Dennis-van-Gils/Infinity_mirror_FastLED/Solidworks/ikea-ribba-frame-23x23cm-1.snapshot.1/RIBBA.JPG

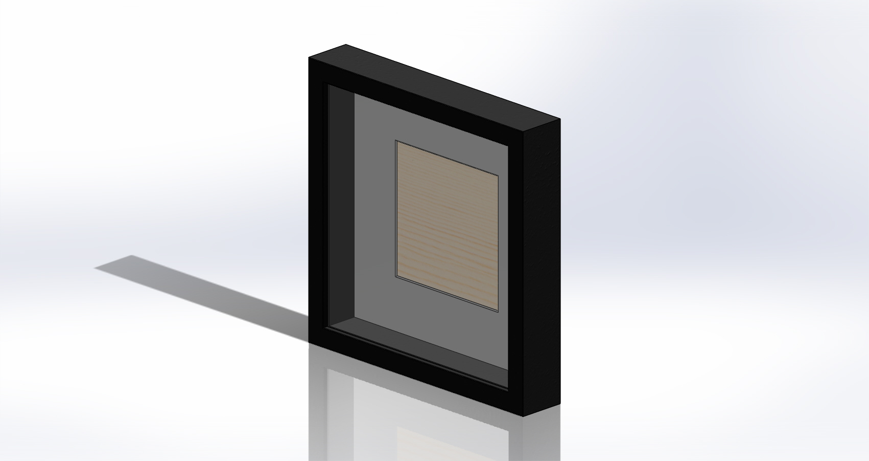
Solidworks/ikea-ribba-frame-23x23cm-1.snapshot.1/RIBBA.JPG
