Dennis-van-Gils/Infinity_mirror_FastLED/Solidworks/mcu_enclosure.PNG

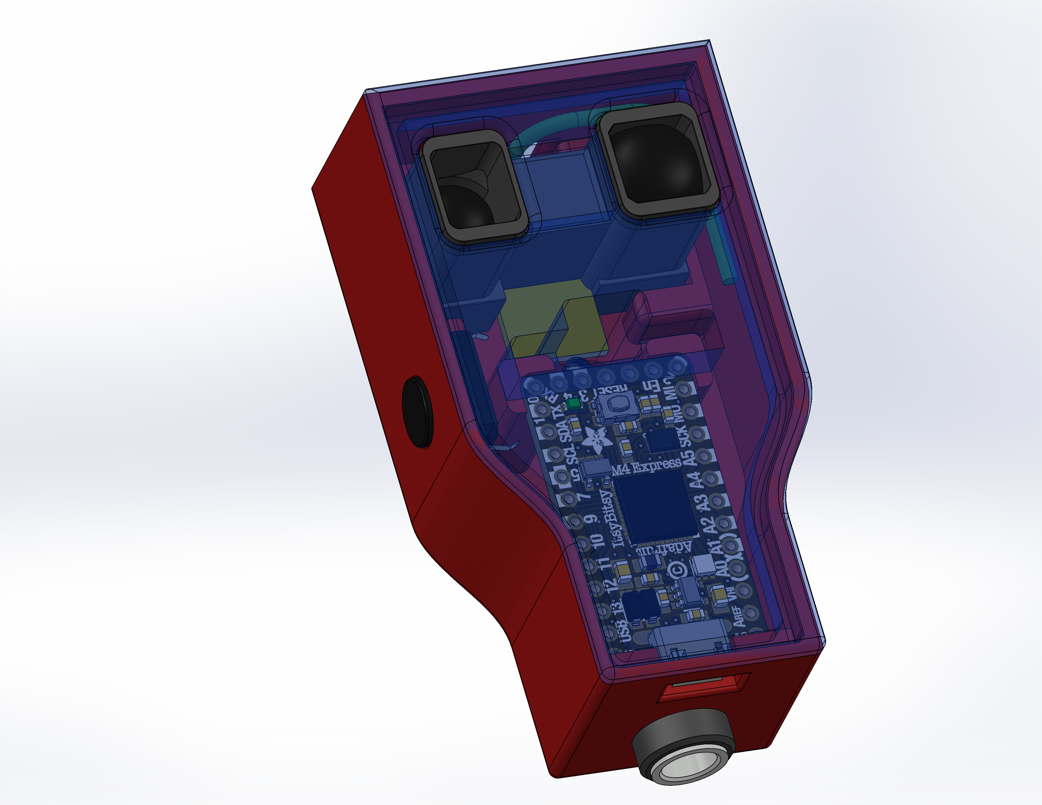
Solidworks/mcu_enclosure.PNG
