Dennis-van-Gils/Infinity_mirror_FastLED/notes.txt

* Adafruit Feather/ItsyBitsy M4 Express

* RGB LED strip
  LS5RGB60 APA102 CP from LEDTUNING.NL
  'Dotstar' type
  5 V, 5050

  Testing 52 leds:
    5 V, 2.5 A switching power supply:
      max current @ full white = 1.3 A

    5 V, 2.0 A switching power supply:
      max current @ full white = 1.13 A
      --> underpowered PSU

  --> strip direction -->

                pin
  VCC - Brown
  CLK - White   SPI_SCK
  DAT - Blue    SPI_MOSI
  GND - Black  

  Adafruit recommends:
  Add a 1000µF (6.3V or higher) capacitor close to the strip between VCC and GND

* IR distance sensor
  Sharp 2Y0A02
  
  Brown: 3.3V
  Black: GND
  Blue : analog out to pin A0 on Arduino           
  
  Fit: distance [cm] = A / bitval ^ C - B, where bitval is at 10-bit
  
* Standby currents
  
  IR distance sensor, running    : ~ 30 mA
  RGB LED strip with all leds off: ~ 58 mA
                                   -------
                                     88 mA
                                     
* SAMD51 Standby mode snippet
  Is hardly worth it, because of the large standby currents of the IR distance
  sensor and RGB LED strip.
  
  #include "Adafruit_SleepyDog.h"
  
  USB->DEVICE.CTRLA.bit.ENABLE = 0;          // Disable the USB peripheral
  while (USB->DEVICE.SYNCBUSY.bit.ENABLE) {} // Wait for synchronization
  USB->DEVICE.CTRLA.bit.RUNSTDBY = 0;        // Deactivate run on standby
  USB->DEVICE.CTRLA.bit.ENABLE = 1;          // Enable USB peripheral
  while (USB->DEVICE.SYNCBUSY.bit.ENABLE) {} // Wait for synchronization

  Watchdog.sleep(1000);
