Dennis-van-Gils/Infinity_mirror_FastLED/docs/UML_FSM.pdf

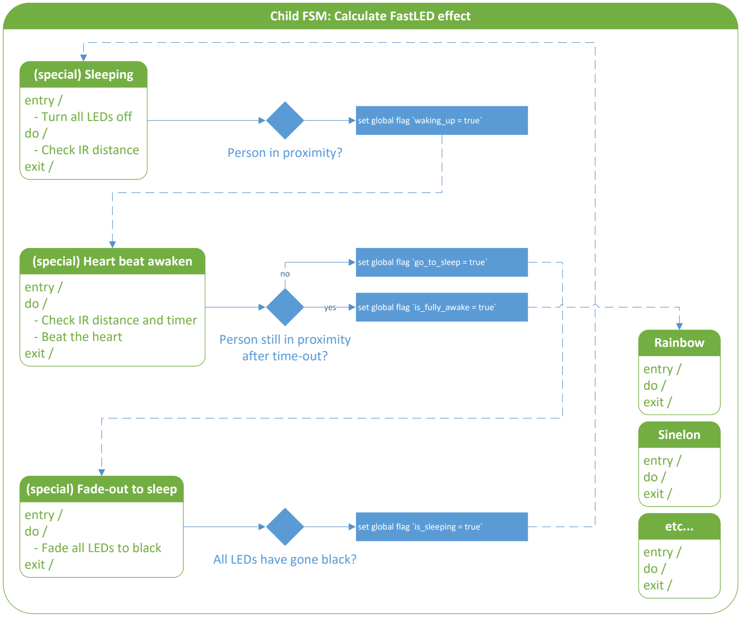
[picture p18: figure]
Child FSM: Calculate FastLED effect; Rainbow; entry / do / exit /; Sinelon; etc...; (special) Heart beat awaken; entry / do / - Check IR distance and timer - Beat the heart exit /; (special) Fade-out to sleep; entry / do / - Fade all LEDs to black exit /; (special) Sleeping; entry / - Turn all LEDs off do / - Check IR distance exit /; Person in proximity?; set global flag `waking_up = true`; All LEDs have gone black?; Person still in proximity after time-out?; set global flag `go_to_sleep = true`; set global flag `is_sleeping = true`

Notes: Modes menu

Menu will indicate mode by lighting up 1 of the 4 corners of the mirror: └ mode 1: show effect from preset list, auto-advance
┘ mode 2: show effect from preset list, no auto-advance
┐ mode 3: show IR distance demo (hue = IR distance)
┌ mode 4: ...

Notes: `Heart beat awaken` effect

Start beating LEDs in red, every beat brighter than the previous. When user is still in proximity after 20 secs then fully awake, else go to sleep again.

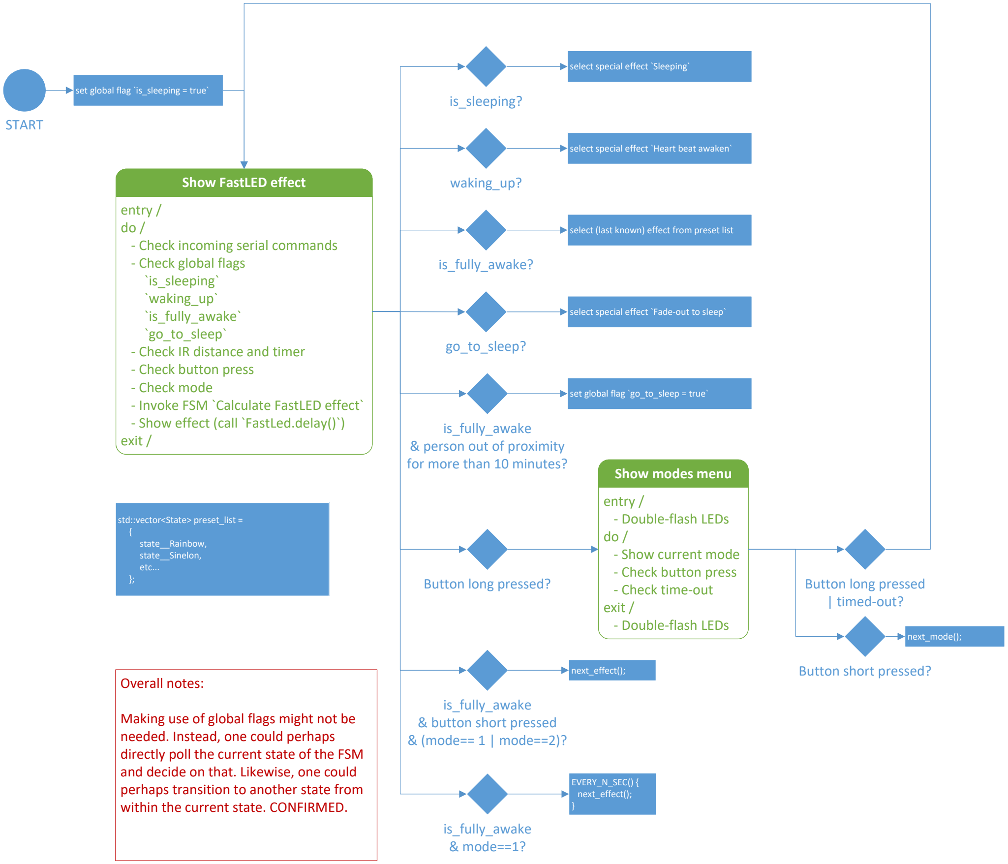
[picture p19: figure]
Show FastLED effect; entry / do / - Check incoming serial commands - Check global flags `is_sleeping` `waking_up` `is_fully_awake` `go_to_sleep` - Check IR distance and timer - Check button press - Check mode - Invoke FSM `Calculate FastLED effect` - Show effect (call `FastLed.delay()`) exit /; Show modes menu; entry / - Double-flash LEDs do / - Show current mode - Check button press - Check time-out exit / - Double-flash LEDs; is_fully_awake & person out of proximity for more than 10 minutes?; Button long pressed?; is_fully_awake & mode==1?; EVERY_N_SEC() { next_effect();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

select (last known) effect from preset list

yes set global flag `is_fully_awake = true` select special effect `Heart beat awaken`

select special effect `Fade-out to sleep`

directly poll the current state of the FSM

perhaps transition to another state from
