Dennis-van-Gils/Infinity_mirror_FastLED/Solidworks/sharp-gp2y0a02yk0f-1.snapshot.4/preview.JPG

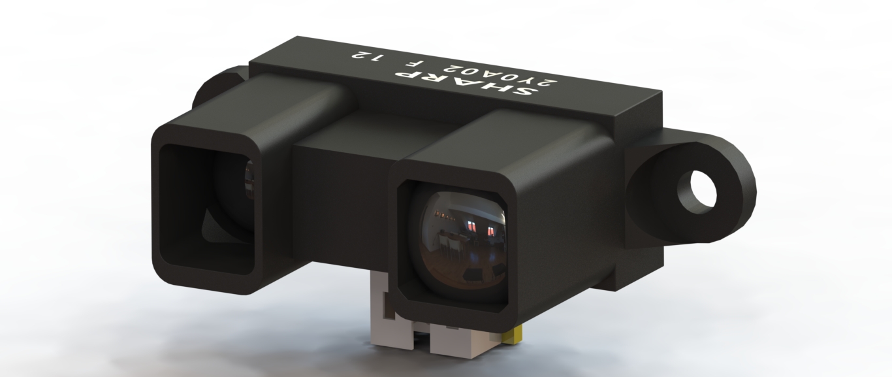
Solidworks/sharp-gp2y0a02yk0f-1.snapshot.4/preview.JPG
