Dennis-van-Gils/Infinity_mirror_FastLED/Solidworks/PoF_logo/PoF_assy - Physics_of_Fluids-1.STL

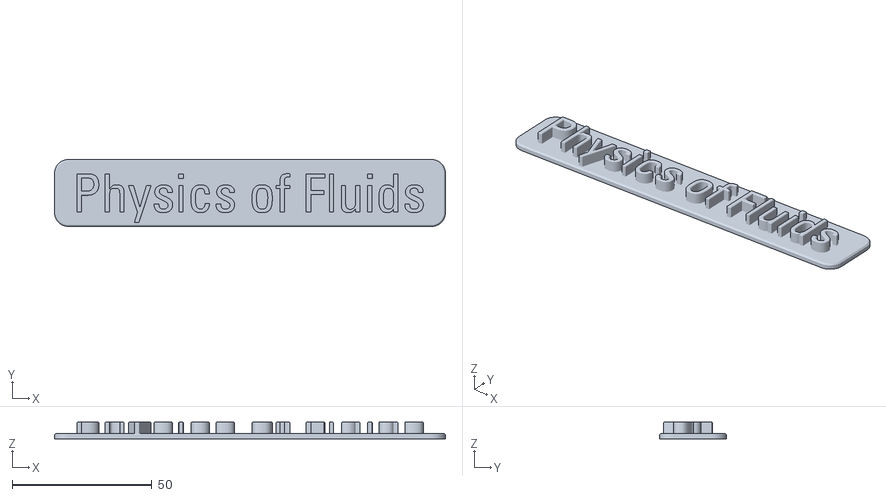
[picture p21: CAD file, 2022-04-22]
Solidworks/PoF_logo/PoF_assy - Physics_of_Fluids-1.STL
140.0 x 24.0 x 6.00
