Dennis-van-Gils/Infinity_mirror_FastLED/Solidworks/mcu_enclosure.SLDASM

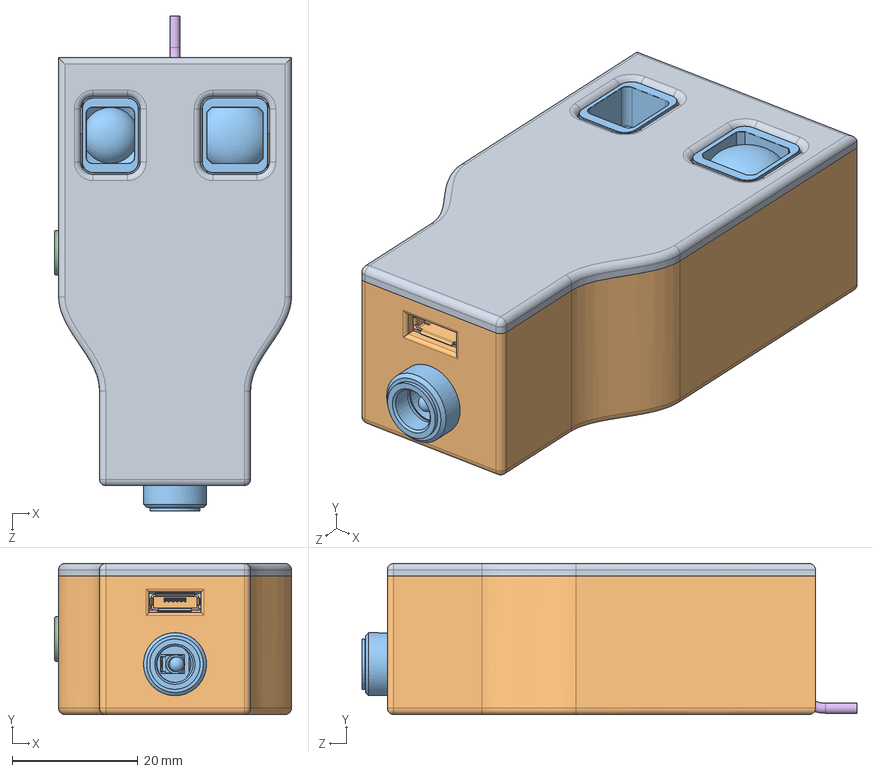
[picture p22: CAD file, 2022-04-16]
Solidworks/mcu_enclosure.SLDASM
37.7 x 24.0 x 78.6 mm
mcu_enclosure
ID_1.stp
Board.step
10_X_B5F.step x 2
100k.step x 6
RED.step
SPST_TACT-KMR2.step
microUSB.step
AP2112K-3.3.step
74HCT1G125DBV.step
MBR120.step x 2
AP102-2020.step
GD25x16.step
ATSAMD51G_TQFN48.step
10uF.step
1uF.step x 3
GP2Y0A02YK0F SHARP_edited
1119 12mm-TactileSwitch
ELCO_8x15mm
LED_cables
mcu_enclosure_lid
DIN EN ISO 7046-1 - M3 x 8 - Z - 8N
