Dennis-van-Gils/Infinity_mirror_FastLED/Solidworks/PoF_logo/PoF_assy - PoF_logo-1.STL

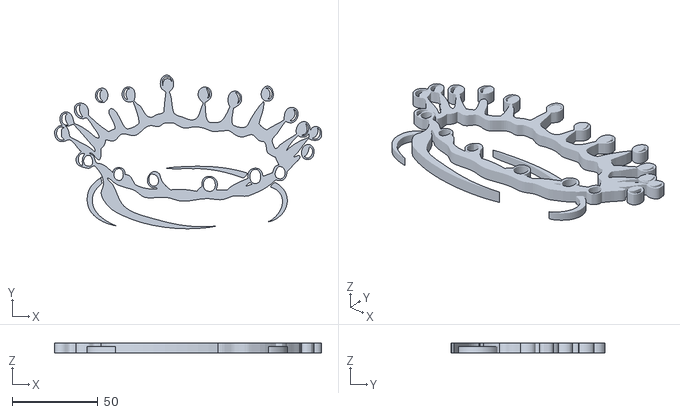
[picture p23: CAD file, 2022-04-22]
Solidworks/PoF_logo/PoF_assy - PoF_logo-1.STL
155.4 x 89.4 x 6.00
