Dennis-van-Gils/Infinity_mirror_FastLED/Solidworks/PoF_logo/PoF_assy.SLDASM

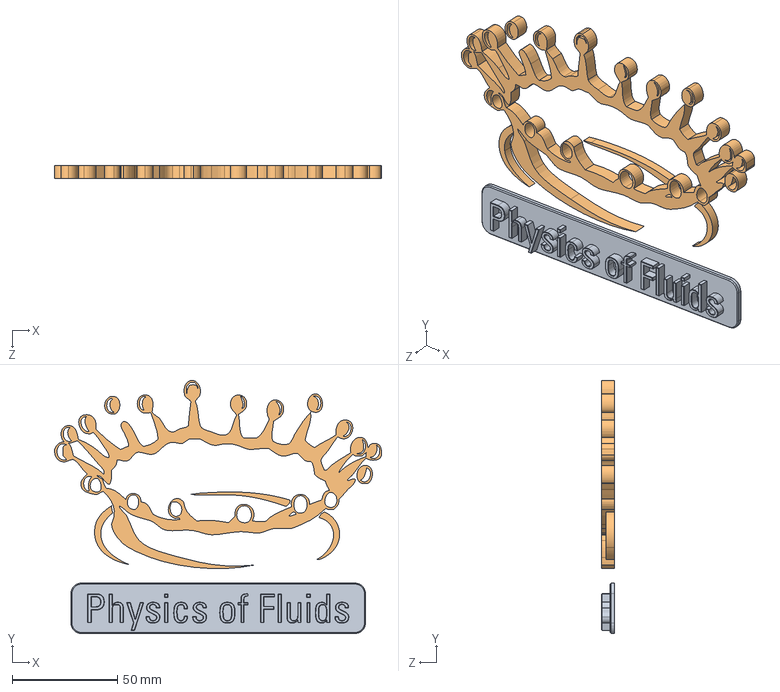
[picture p24: CAD file, 2022-04-22]
Solidworks/PoF_logo/PoF_assy.SLDASM
155.4 x 120.3 x 6.00 mm
Physics_of_Fluids
PoF_logo
