Dennis-van-Gils/Infinity_mirror_FastLED/Solidworks/ikea-ribba-frame-23x23cm-1.snapshot.1/RIBBA.STEP

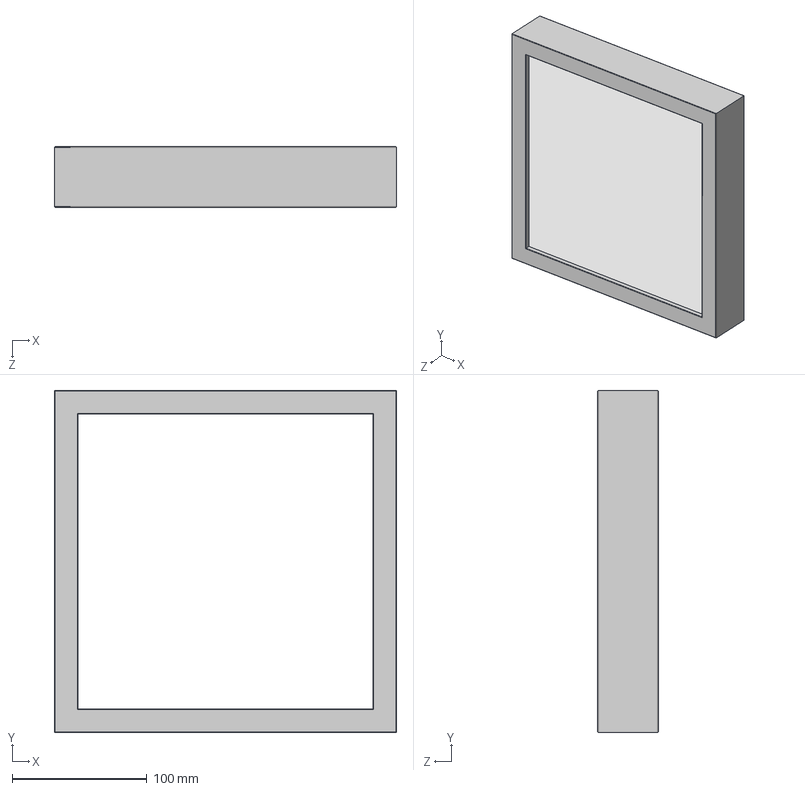
[picture p26: CAD file, 2022-04-03]
Solidworks/ikea-ribba-frame-23x23cm-1.snapshot.1/RIBBA.STEP
254.0 x 254.0 x 45.0 mm
Outer^RIBBA
Glass^RIBBA
Inner^RIBBA
Matte^RIBBA
Back^RIBBA
