Dennis-van-Gils/Infinity_mirror_FastLED/Solidworks/mcu_enclosure_lid.SLDPRT

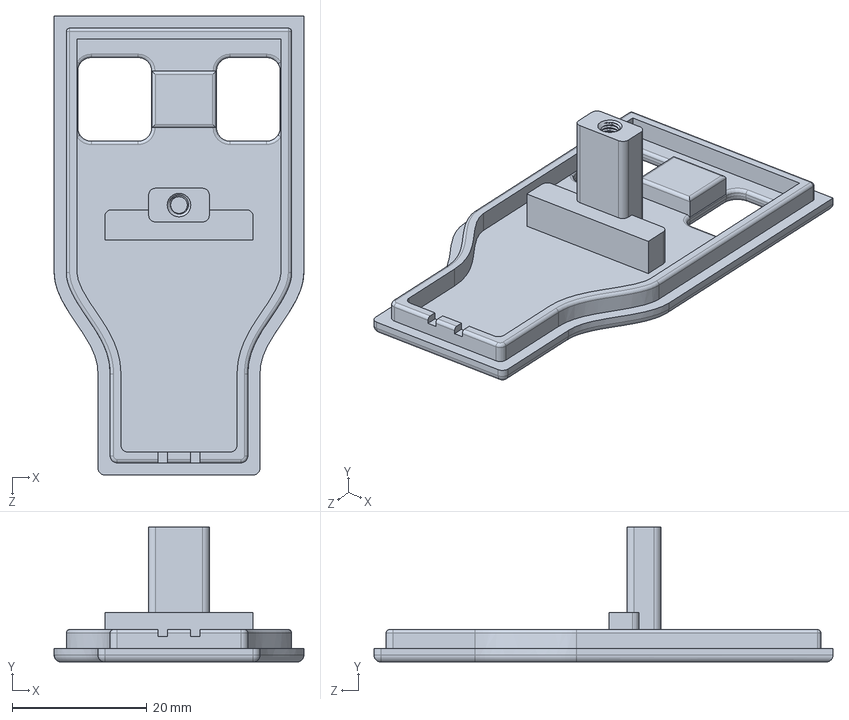
[picture p27: CAD file, 2022-04-16]
Solidworks/mcu_enclosure_lid.SLDPRT
37.0 x 20.0 x 68.0 mm
