Dennis-van-Gils/Infinity_mirror_FastLED/Solidworks/sharp-gp2y0a02yk0f-1.snapshot.4/GP2Y0A02YK0F SHARP.SLDPRT

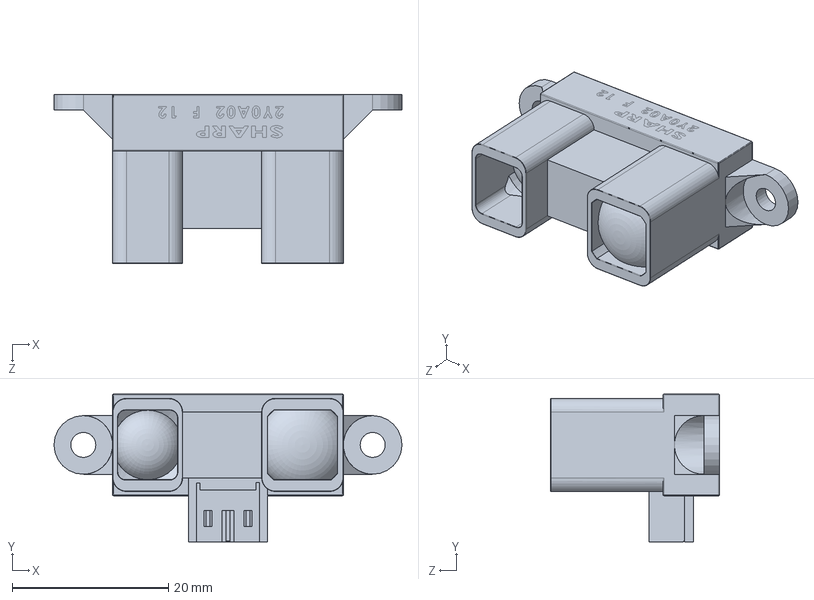
[picture p29: CAD file, 2022-04-03]
Solidworks/sharp-gp2y0a02yk0f-1.snapshot.4/GP2Y0A02YK0F SHARP.SLDPRT
44.5 x 18.9 x 21.6 mm
