Dennis-van-Gils/Infinity_mirror_FastLED/Solidworks/suspension_plate.SLDPRT

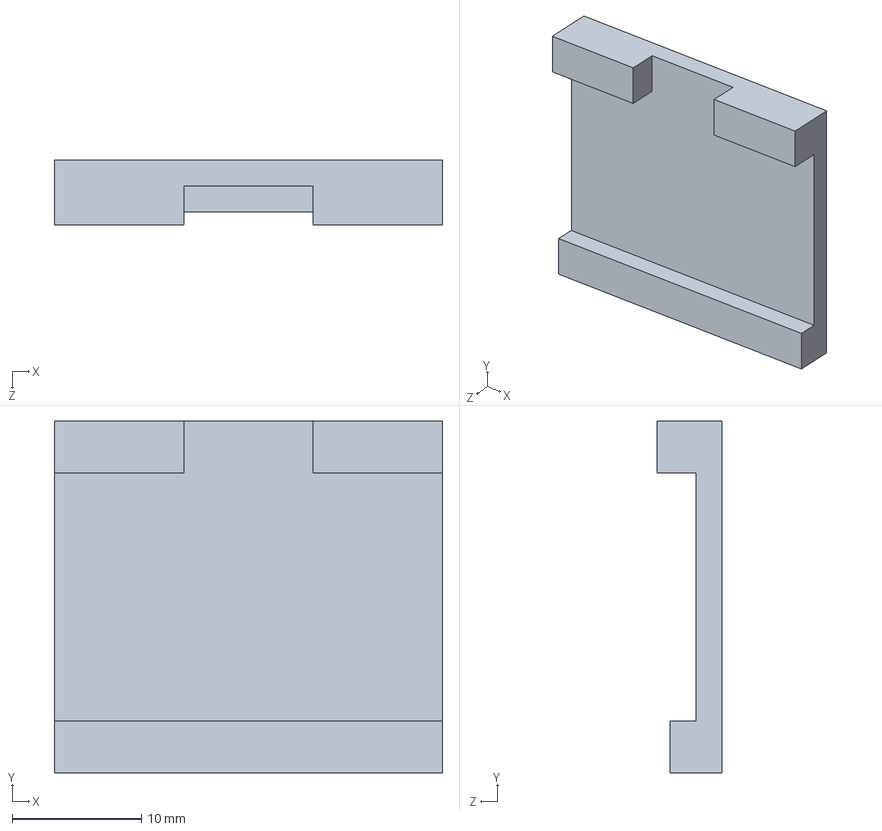
[picture p30: CAD file, 2022-04-03]
Solidworks/suspension_plate.SLDPRT
30.0 x 27.2 x 5.00 mm
