Dennis-van-Gils/Infinity_mirror_FastLED/Solidworks/DIN EN ISO 7046-1 - M3 x 8 - Z - 8N.SLDPRT

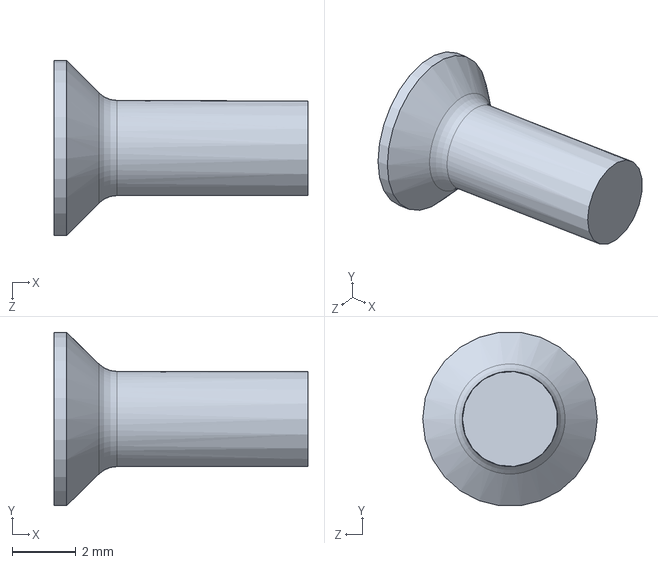
[picture p31: CAD file, 2022-04-03]
Solidworks/DIN EN ISO 7046-1 - M3 x 8 - Z - 8N.SLDPRT
8.00 x 5.46 x 5.50 mm
