Dennis-van-Gils/Infinity_mirror_FastLED/Solidworks/LED_cables.SLDPRT

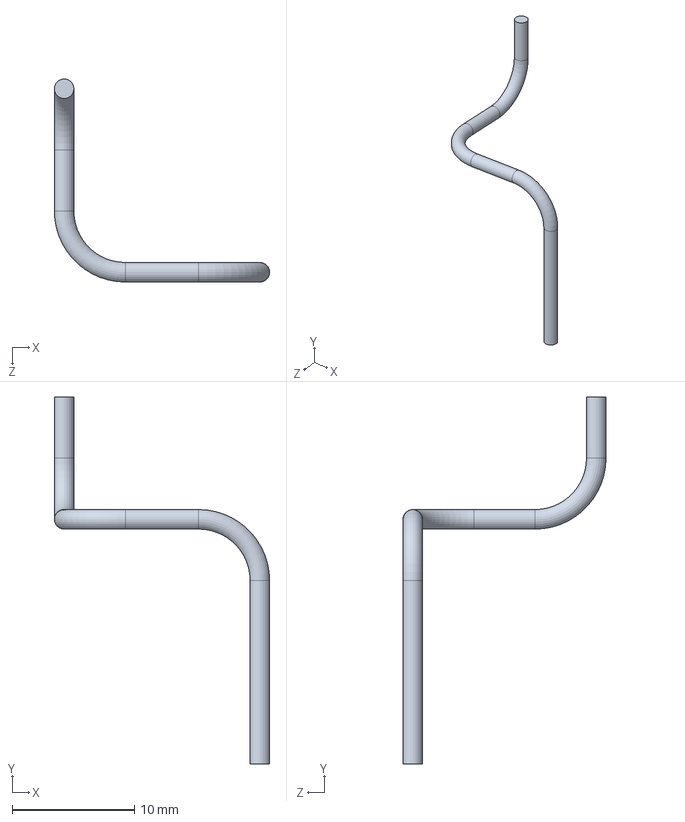
[picture p32: CAD file, 2022-04-03]
Solidworks/LED_cables.SLDPRT
17.6 x 30.0 x 16.6 mm
