Dennis-van-Gils/Infinity_mirror_FastLED/Solidworks/PoF_logo/PoF_logo_fillet.SLDPRT

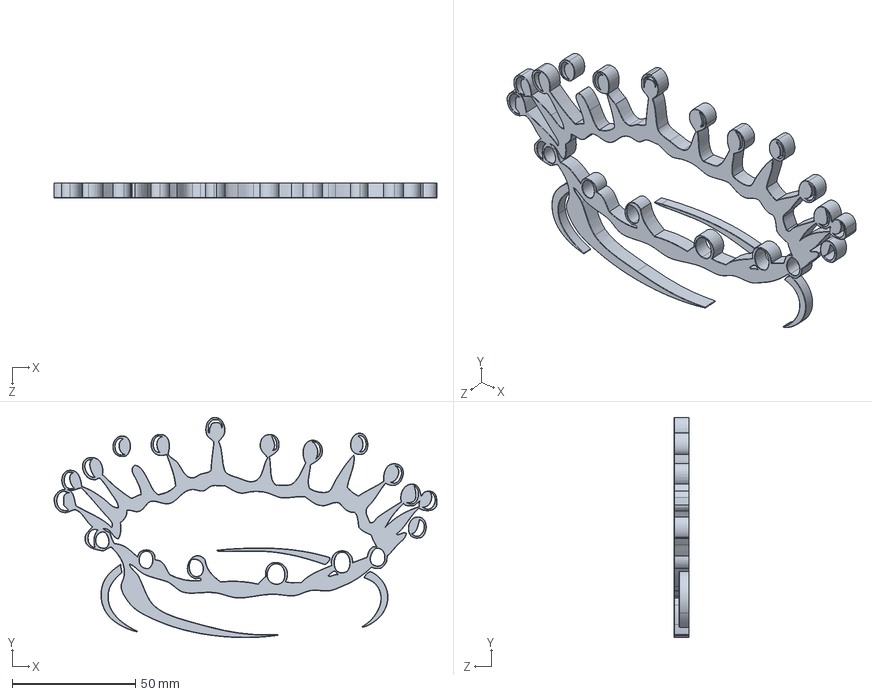
[picture p33: CAD file, 2022-04-22]
Solidworks/PoF_logo/PoF_logo_fillet.SLDPRT
155.4 x 89.4 x 6.00 mm
