Dennis-van-Gils/Infinity_mirror_FastLED/(list of files, cad)

Other CAD files:
Solidworks/PoF_logo/Physics_of_Fluids.SLDPRT
Solidworks/PoF_logo/PoF_logo.SLDPRT
Solidworks/PoF_logo/Physics_of_Fluids.dwg
Solidworks/PoF_logo/PoF_logo.dwg
Solidworks/_3D_print/mcu_enclosure.STL
Solidworks/_3D_print/mcu_enclosure_lid.STL
Solidworks/_3D_print/suspension_plate.STL
Solidworks/ikea-ribba-frame-23x23cm-1.snapshot.1/RIBBA.SLDASM
Solidworks/mcu_enclosure.SLDPRT
