Dennis-van-Gils/Infinity_mirror_FastLED/docs/Eagle/infinity_mirror.pdf

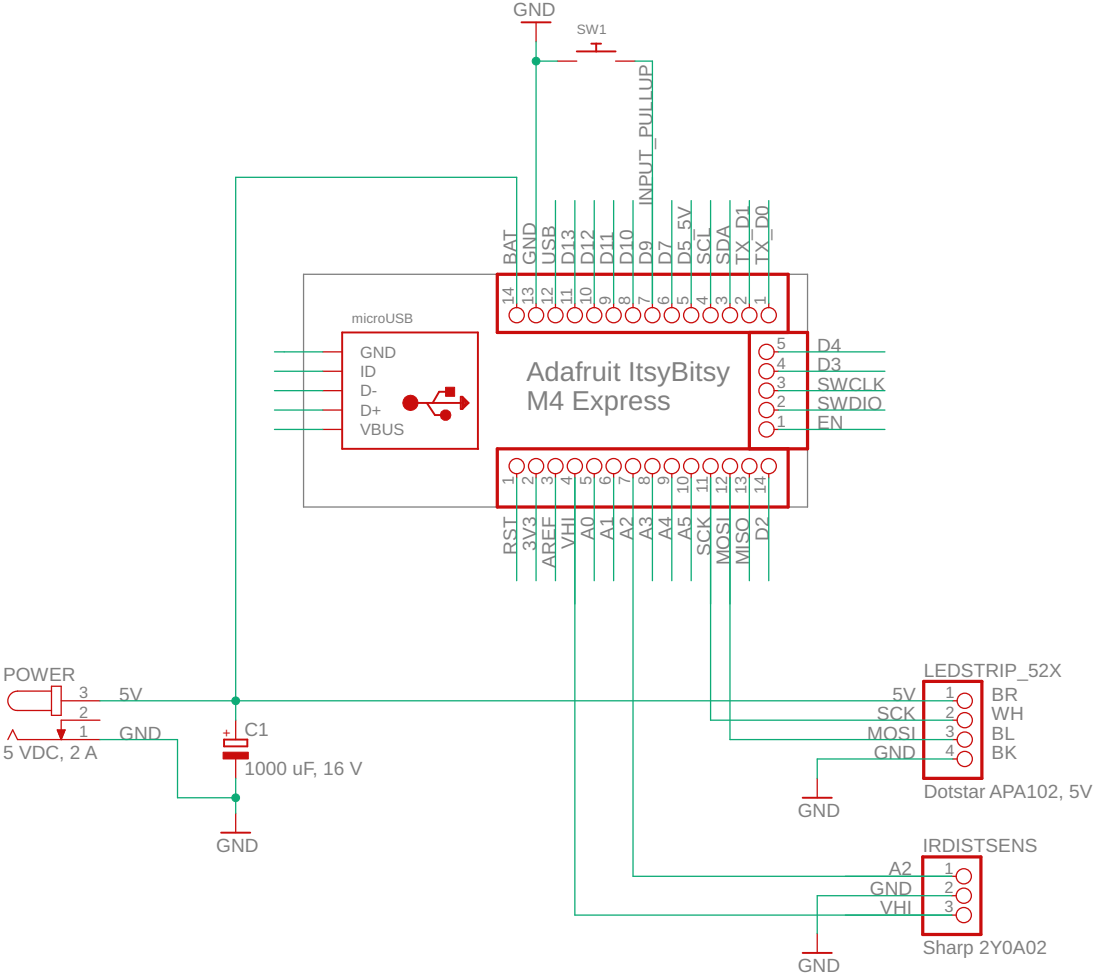
[picture p34: page 1]

microUSB
D+ D- VBUS GND ID | Adafruit ItsyBitsy M4 Express | 5 4 3 2 1
