Dennis-van-Gils/Infinity_mirror_FastLED/docs/calibration_IR_sensor/IR_sensor_fit.pdf

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

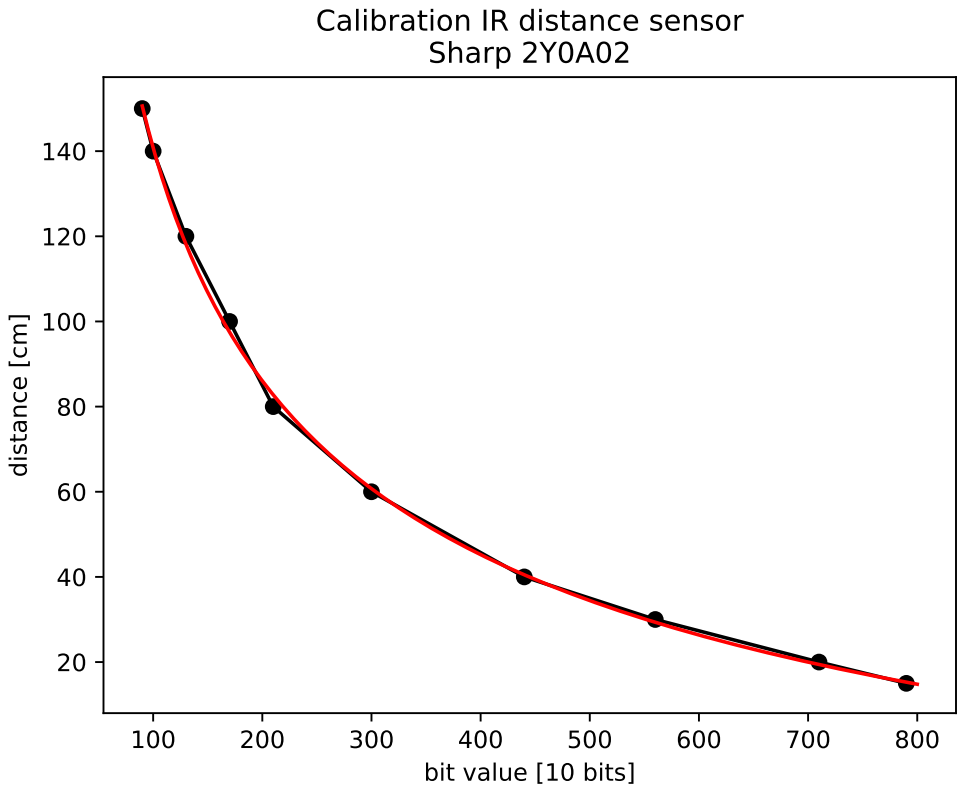
[picture p35: page 1]
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
