Dennis-van-Gils/Infinity_mirror_FastLED/docs/Eagle/infinity_mirror.sch

## EAGLE design docs/Eagle/infinity_mirror.sch (2022-04-16)

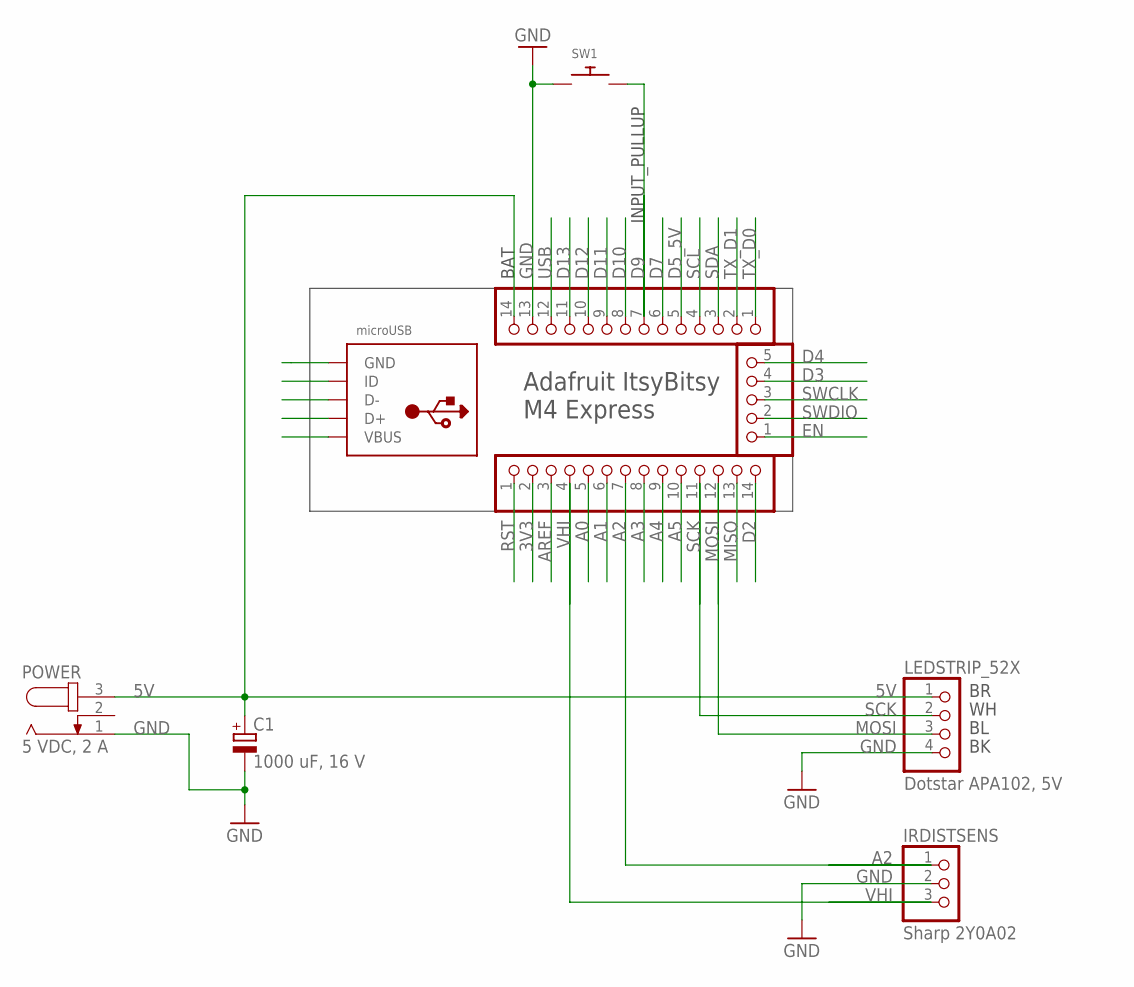
[picture p36: schematic infinity_mirror.sch]

Parts:
C1: 1000 uF, 16 V; E3,5-8
IRDISTSENS: Sharp 2Y0A02; 1X03
JP1, JP2: PINHD-1X14; 1X14
JP4: PINHD-1X5; 1X05
LEDSTRIP_52X: Dotstar APA102, 5V; 1X04
POWER: 5 VDC, 2 A; SPC4078
SW1: SWITCH_PUSHBUTTONSOFTTOUCHSMD_SJ; PUSHBUTTON_SMD_SJ
X3: microUSB; 4UCONN_20329_V2

Connections:
3V3: JP2.2
5V: C1.+, JP1.14, LEDSTRIP_52X.1, POWER.3
A0: JP2.5
A1: JP2.6
A2: IRDISTSENS.1, JP2.7
A3: JP2.8
A4: JP2.9
A5: JP2.10
AREF: JP2.3
D2: JP2.14
D3: JP4.4
D4: JP4.5
D5_5V: JP1.5
D7: JP1.6
D9: JP1.7, SW1.P$2
D10: JP1.8
D11: JP1.9
D12: JP1.10
D13: JP1.11
EN: JP4.1
GND: C1.-, IRDISTSENS.2, JP1.13, LEDSTRIP_52X.4, POWER.1, SW1.P$1
MISO: JP2.13
MOSI: JP2.12, LEDSTRIP_52X.3
RST: JP2.1
SCK: JP2.11, LEDSTRIP_52X.2
SCL: JP1.4
SDA: JP1.3
SWCLK: JP4.3
SWDIO: JP4.2
TX_D0: JP1.1
TX_D1: JP1.2
USB: JP1.12
VHI: IRDISTSENS.3, JP2.4

Notes on the sheet:
Adafruit ItsyBitsy M4 Express
INPUT_PULLUP
BAT
