Dennis-van-Gils/Infinity_mirror_FastLED/(commit log)

2020-09-24 Experimenting with IR distance sensor
2020-09-25 Extended patterns
    [fastLED_segmenting.xlsx]
2020-09-26 In progress: LEDs segmenting styles
2021-11-13 Major in progress of implementing LED segmentor
2021-11-14 Proof of concept works: LED segmentor
2021-11-14 Refactoring & added `print_style()`
2021-11-17 Improved FSM. Print effect name to serial monitor.
2021-11-20 Calibrated IR sensor
2021-11-20 Finished: streamlined Effects
    [diagram.xlsx]
2021-11-21 Added master switch ON/OFF
2021-11-21 Shortened variable name `ledfx1 -> `fx1`
    [DvG_FastLED_effects.h]
2021-11-21 Increase the frame rate. Tested okay on M4
2021-11-21 Show debug info on frame rate
2021-11-21 Added running average on IR distance sensor
2021-11-21 Changed variable name `leds_output_is_in` to `ENA_leds`
2021-11-22 Fixed index past size
    [main.cpp]
2021-11-24 Measured current
    [psu_infinity_mirror.xlsx]
2021-11-27 Improved master switches
2021-11-27 Print key bindings to terminal
    [main.cpp]
2021-12-04 Fixed starting up `RainbowBarf/Surf`
    [DvG_FastLED_effects.h, main.cpp]
2021-12-04 Shortened namespace `FastLEDConfig` to `FLC`
    [DvG_FastLED_StripSegmenter.h, DvG_FastLED_config.h, DvG_FastLED_effects.h, main.cpp]
2021-12-04 Fixed glaring mistake `ECG_N_SMP = 255` to `256`
    [DvG_FastLED_effects.h, main.cpp]
2022-04-02 Specify wiring IR distance sensor
2022-04-03 MCU enclosure
    [DIN EN ISO 7046-1 - M3 x 8 - Z - 8N.SLDPRT, GP2Y0A02YK0F SHARP.SLDPRT, GP2Y0A02YK0F SHARP_edited.SLDPRT, LED_cables.SLDPRT, RIBBA.SLDASM, RIBBA.STEP, _full_assy.SLDASM, mcu_enclosure.SLDASM]
2022-04-03 Added suspension plate
    [RIBBA.SLDASM, _full_assy.SLDASM, mcu_enclosure.SLDASM, mcu_enclosure.SLDPRT, suspension_plate.SLDPRT]
2022-04-04 Added chamfer
    [mcu_enclosure.SLDASM, mcu_enclosure.SLDPRT, mcu_enclosure.STL, mcu_enclosure_lid.SLDPRT]
2022-04-16 Squashed commit of the following:
    commit d50f4d40b153b6629299b490b275e7fb4ade315b
    Author: Dennis van Gils <37263907+Dennis-van-Gils@users.noreply.github.com>
    Date: Sat Apr 16 14:05:48 2022 +0200
    Finished settings onboard RGB LED to black
    commit 3e35a4169f2f23ac658472513231a58edf123eb0
    Author: Dennis van Gils <37263907+Dennis-van-Gils@users.noreply.github.com>
    Date: Sat Apr 16 00:00:56 2022 +0200
    TEST: Remove onboard RGB LED from the FastLED controllers after set to black
    commit e6a715184067b00c6b560bce78573d08e56d48bc
    Author: Dennis van Gils <37263907+Dennis-van-Gils@users.noreply.github.com>
    Date: Fri Apr 15 23:53:41 2022 +0200
    Improved and stabilized the FPS
    commit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
    [infinity_mirror.sch, mcu_enclosure.SLDASM, mcu_enclosure.SLDPRT, mcu_enclosure_lid.SLDPRT]
2022-04-16 Updated Switch library. Fixes compiler warnings
2022-04-18 Added notes on standby currents and deep-sleep mode SAMD51
2022-04-19 Added additional shorter time-out to check for audience at start
    [DvG_FastLED_EffectManager.h, DvG_FastLED_effects.h, main.cpp]
2022-04-20 3D print
    [mcu_enclosure_lid.STL]
2022-04-21 Suspension plate
    [suspension_plate.STL]
2022-04-22 Reorganize folder structure
    [Physics_of_Fluids.SLDPRT, Physics_of_Fluids.dwg, PoF_assy - Physics_of_Fluids-1.STL, PoF_assy - PoF_logo-1.STL, PoF_assy.SLDASM, PoF_logo.SLDPRT, PoF_logo.dwg, PoF_logo_fillet.SLDPRT]
2022-04-22 Improved brightness table. Each advancing list value will ensure lighting up an extra led in the VU meter.
2022-05-13 Fix `serial` to `ser`
    [main.cpp]
2023-03-31 Fix major sleeping bug in `getCurrentStateName()`
    [DvG_FastLED_EffectManager.h]
